Yasho29/cim-mnist-accelerator/figures/phase1/mac_output_histogram_before_adc.png

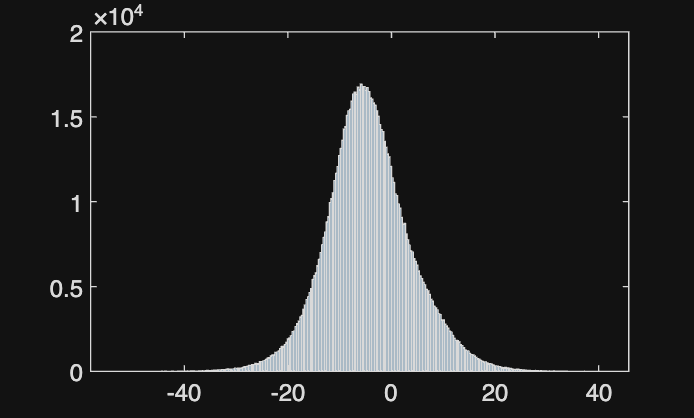
figures/phase1/mac_output_histogram_before_adc.png
