Yasho29/cim-mnist-accelerator/figures/phase2/bitline_voltage_monte_carlo.png

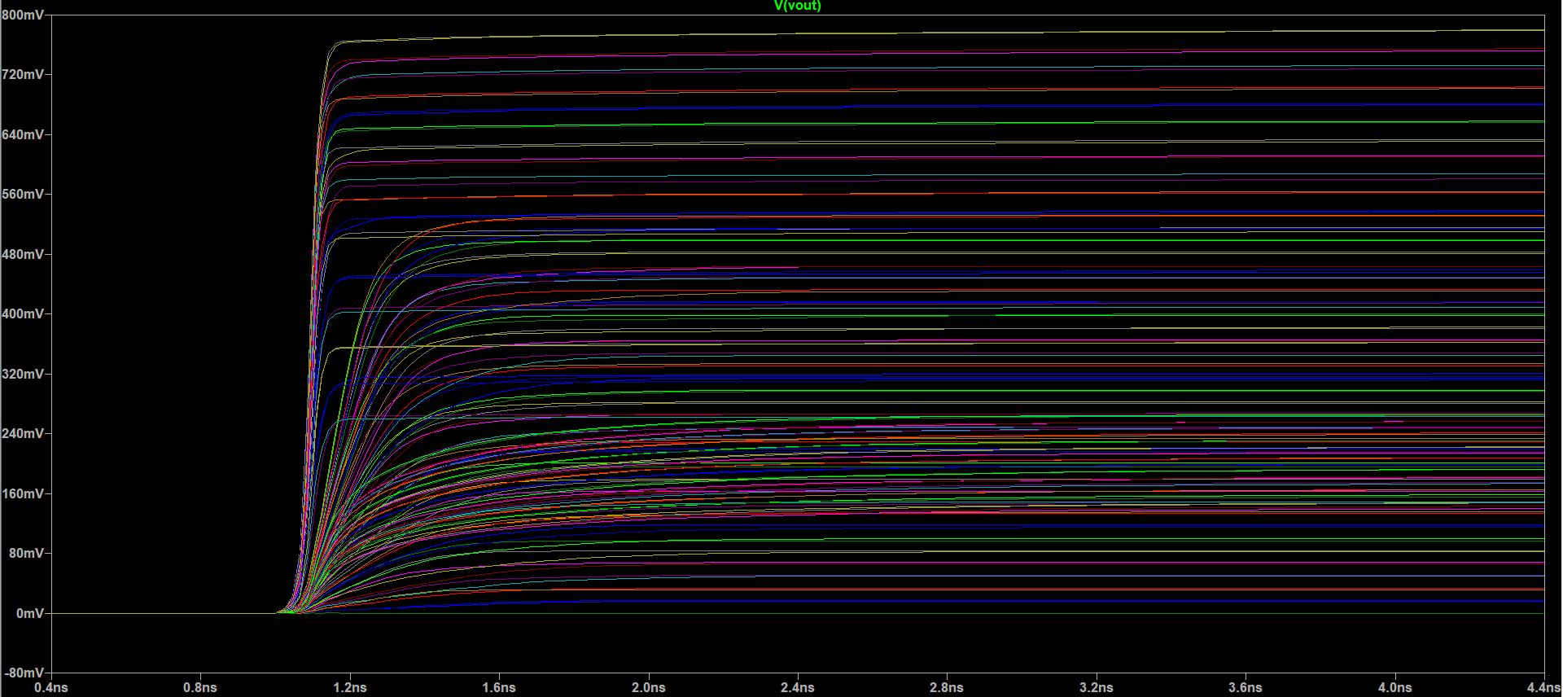
figures/phase2/bitline_voltage_monte_carlo.png
