Yasho29/cim-mnist-accelerator/figures/phase2/dac_settling_code01.png

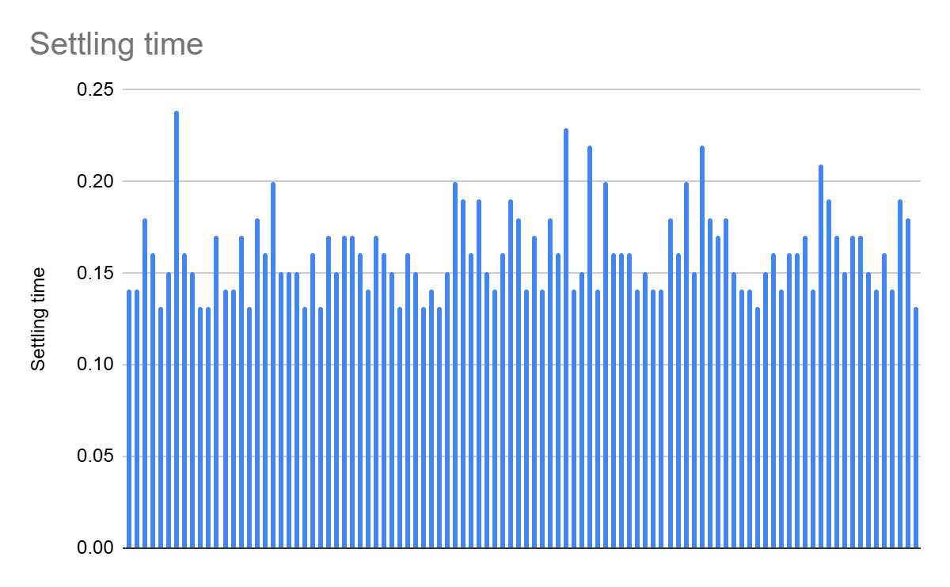
figures/phase2/dac_settling_code01.png
