Yasho29/cim-mnist-accelerator/figures/phase2/dac_settling_code10.png

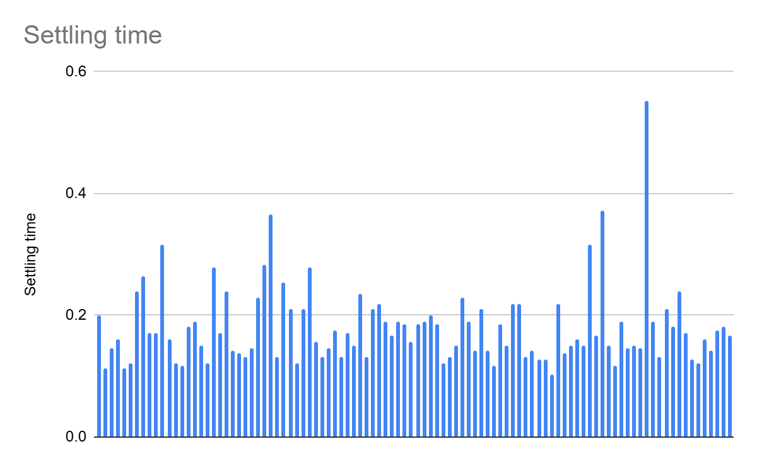
figures/phase2/dac_settling_code10.png
