Yasho29/cim-mnist-accelerator/figures/phase2/dac_settling_code11.png

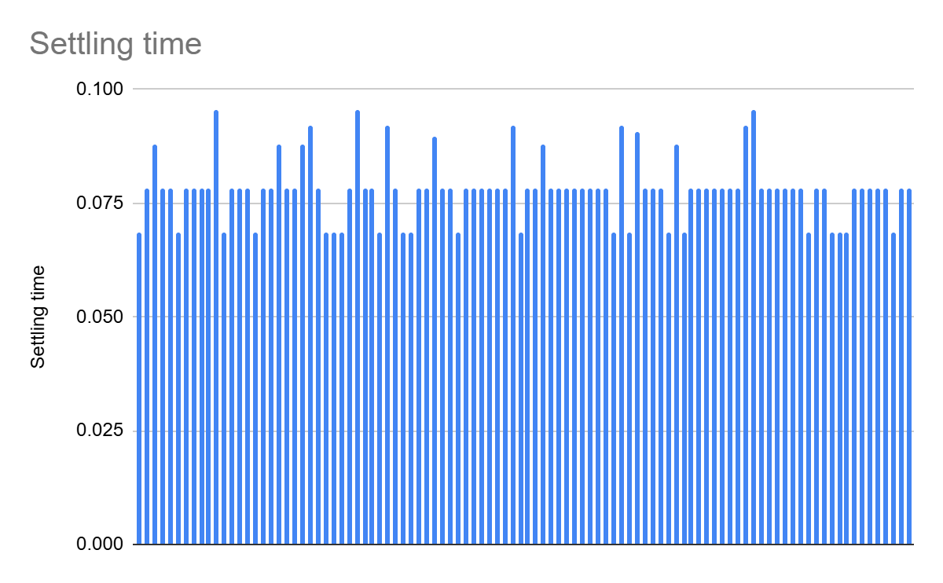
figures/phase2/dac_settling_code11.png
