Yasho29/cim-mnist-accelerator/ltspice/DAC.asc

M1: nmos4; nmos_22; l=22nm w={w_n_switch} delvto={gc({Vt0_n},{sig_n_switch})}
M2: pmos4; pmos_22; l=22nm w={w_p_switch} delvto={gc({Vt0_p},{sig_p_switch})}
M3: nmos4; nmos_22; l=22nm w={w_n_switch} delvto={gc({Vt0_n},{sig_n_switch})}
M4: pmos4; pmos_22; l=22nm w={w_p_switch} delvto={gc({Vt0_p},{sig_p_switch})}
M5: nmos4; nmos_22; l=22nm w={w_n_switch} delvto={gc({Vt0_n},{sig_n_switch})}
M6: pmos4; pmos_22; l=22nm w={w_p_switch} delvto={gc({Vt0_p},{sig_p_switch})}
M7: nmos4; nmos_22; l=22nm w={w_n_switch} delvto={gc({Vt0_n},{sig_n_switch})}
M8: pmos4; pmos_22; l=22nm w={w_p_switch} delvto={gc({Vt0_p},{sig_p_switch})}
M9: nmos4; nmos_22; l=22nm w={w_n_switch} delvto={gc({Vt0_n},{sig_n_switch})}
M10: pmos4; pmos_22; l=22nm w={w_p_switch} delvto={gc({Vt0_p},{sig_p_switch})}
M11: nmos4; nmos_22; l=22nm w={w_n_switch} delvto={gc({Vt0_n},{sig_n_switch})}
M12: pmos4; pmos_22; l=22nm w={w_p_switch} delvto={gc({Vt0_p},{sig_p_switch})}
M13: nmos4; nmos_22; l=22nm w={w_nmos}; delvto={gc({Vt0_n},{sig_n_inv})}
M14: pmos4; pmos_22; l=22nm w={w_pmos}; delvto={gc({Vt0_p},{sig_p_inv})}
M15: nmos4; nmos_22; l=22nm w={w_nmos}; delvto={gc({Vt0_n},{sig_n_inv})}
M16: pmos4; pmos_22; l=22nm w={w_pmos}; delvto={gc({Vt0_p},{sig_p_inv})}
R1: res; {R}
R2: res; {R}
R3: res; {R}
V1: voltage; 0.8
Named nets: 0, VDD, S0, S1, S0b, S1b, output
.param R=1k
.param w_nmos=50nm w_pmos=100nm
.param w_n_switch=50nm w_p_switch=200nm
.func gc(mean,sigma)(mean*gauss(sigma))
.param Vt0_n=0.50308
.param Vt0_p=-0.4606
.param sigma_mos=0.1
.param Lmin=22e-09
.param Wmin=44e-09
.param L=22e-09
.param sig_n_inv={(sigma_mos*sqrt(Lmin*Wmin))/sqrt(L*w_nmos)}
.param sig_p_inv={(sigma_mos*sqrt(Lmin*Wmin))/sqrt(L*w_pmos)}
Function and standard values
Sigma values
.param sig_n_switch={(sigma_mos*sqrt(Lmin*Wmin))/sqrt(L*w_p_switch)}
.param sig_p_switch={(sigma_mos*sqrt(Lmin*Wmin))/sqrt(L*w_n_switch)}
.include 22nm_HP.pm
