Yasho29/cim-mnist-accelerator/ltspice/two_bit_weight_row.asc

C1: cap; {C}
V1: voltage; 0.8
V2: voltage; PULSE(0 0.8 1n 100p 100p 100m)
X1: vt_cell; Q={Q1} Qb={Qb1}
X2: DAC
X3: transmissiongate_switch
Named nets: 0, wl_step, input, VDD, output, bit0, bit1
.param b0 = floor(CODE/1)  - 2*floor(CODE/2)
.param b1 = floor(CODE/2)  - 2*floor(CODE/4)
.param b2 = floor(CODE/4)  - 2*floor(CODE/8)
.param b3 = floor(CODE/8)  - 2*floor(CODE/16)
.param b4 = floor(CODE/16) - 2*floor(CODE/32)
.param b5 = floor(CODE/32) - 2*floor(CODE/64)
.param Q1=b0*0.8
.param Q2=b1*0.8
.param Q3=b2*0.8
.param Q4=b3*0.8
.param Q5=b4*0.8
.param Q6=b5*0.8
.param Qb1=if(Q1==0, 0.8,0)
.param Qb2=if(Q2==0, 0.8,0)
.param Qb3=if(Q3==0, 0.8,0)
.param Qb4=if(Q4==0, 0.8,0)
.param Qb5=if(Q5==0, 0.8,0)
.param Qb6=if(Q6==0, 0.8,0)
.param CODE={CODE}
Assigns value to each of the compute cells
.step param CODE 0 63 1
.meas tran vout FIND V(output) AT=5n
DAC: takes 2 bit input
.param C={gc(1f,sigma_cap)} C2={gc(2f,sigma_cap)}
.include 22nm_HP.pm
.param sigma_cap=0.05
.func gc(mean,sigma)(mean*(1+gauss(sigma)))
Capacitor vt variation
.param w_nmos=250nm w_pmos=50nm
.param Vt0_n=0.50308
.param Vt0_p=-0.4606
.param sigma_mos=0.1
.param Lmin=22e-09
.param Wmin=44e-09
Function and standard values
.tran 10n
