Yasho29/cim-mnist-accelerator/ltspice/vt_cell.asc

M1: nmos4; nmos_22; l=22nm w={w_nmos}; delvto={gc({Vt0_n},{sig_n})}
M2: nmos4; nmos_22; l=22nm w={w_nmos}; delvto={gc({Vt0_n},{sig_n})}
M3: nmos4; nmos_22; l=22nm w={w_nmos_a}; delvto={gc({Vt0_n},{sig_n_a})}
M4: nmos4; nmos_22; l=22nm w={w_nmos_a}; delvto={gc({Vt0_n},{sig_n_a})}
M5: pmos4; pmos_22; l=22nm w={w_pmos}; delvto={gc({Vt0_p},{sig_p})}
M6: pmos4; pmos_22; l=22nm w={w_pmos}; delvto={gc({Vt0_p},{sig_p})}
M7: nmos4; nmos_22; l=22nm w={w_nmosr}; delvto={gc({Vt0_n},{sig_n_r})}
M8: nmos4; nmos_22; l=22nm w={w_nmos}; delvto={gc({Vt0_n},{sig_n})}
M9: nmos4; nmos_22; l=22nm w={w_nmos}; delvto={gc({Vt0_n},{sig_n})}
M10: pmos4; pmos_22; l=22nm w={w_pmos}; delvto={gc({Vt0_p},{sig_p})}
M11: nmos4; nmos_22; l=22nm w={w_nmos_a}; delvto={gc({Vt0_n},{sig_n_a})}
V1: voltage; 0.8
Named nets: 0, VDD, BL, BR, WL, RWL, RBL, Qb, Q, CWL, CBL
.include 22nm_HP.pm
.param w_nmos=50nm w_pmos=100nm w_nmosr=200nm w_nmoswr=100nm w_nmos_a=600nm
.ic V(Q)={Q} V(Qb)={Qb}
.func gc(mean,sigma)(mean*gauss(sigma))
.param Vt0_n=0.50308
.param Vt0_p=-0.4606
.param sigma_mos=0.1
.param Lmin=22e-09
.param Wmin=44e-09
.param L=22e-09
.param sig_n={(sigma_mos*sqrt(Lmin*Wmin))/sqrt(L*w_nmos)}
.param sig_n_r={(sigma_mos*sqrt(Lmin*Wmin))/sqrt(L*w_nmosr)}
.param sig_p={(sigma_mos*sqrt(Lmin*Wmin))/sqrt(L*w_pmos)}
Function and standard values
Sigma values
.ic V(BL)=0.8 V(BR)=0.8
.param sig_n_a={(sigma_mos*sqrt(Lmin*Wmin))/sqrt(L*w_nmos_a)}
