Yasho29/cim-mnist-accelerator/(commit log)

2026-10-21 Charge-domain compute-in-memory accelerator for MNIST
2026-10-23 Add LTspice schematics for the compute cell, DAC, switch and weight-row testbench
